fafabot/HomeWise/HomeWise_CAD_preliminar/homewise_cad/08_suporte_3d_case_pzem004t.stl

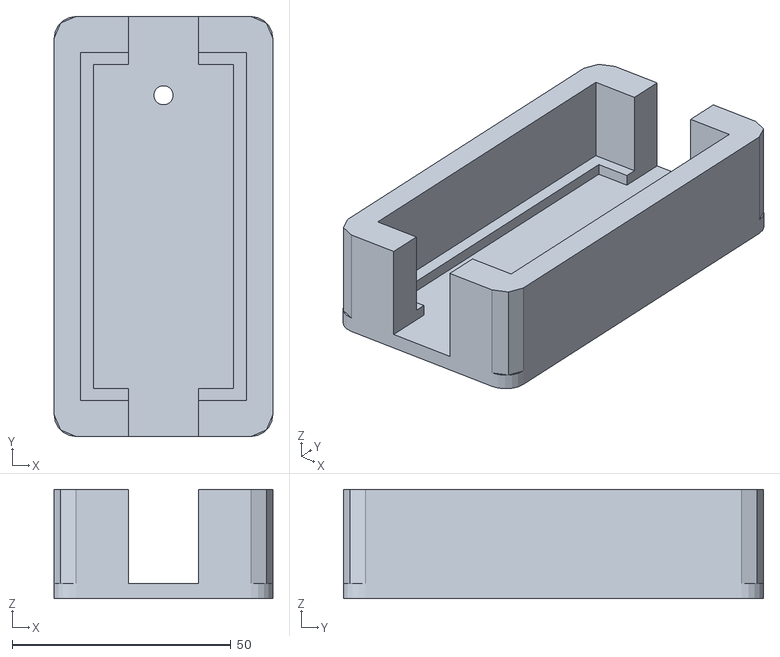
[picture p3: CAD file, 2026-11-12]
HomeWise_CAD_preliminar/homewise_cad/08_suporte_3d_case_pzem004t.stl
50.0 x 96.0 x 25.0
