fafabot/HomeWise/HomeWise_CAD_preliminar/homewise_cad/HomeWise_estrutura.stl

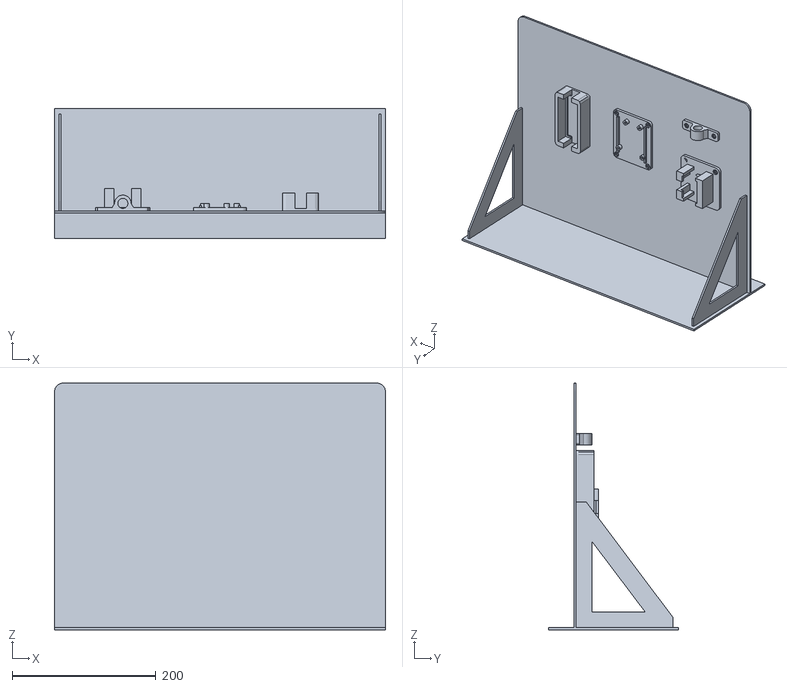
[picture p4: CAD file, 2026-11-12]
HomeWise_CAD_preliminar/homewise_cad/HomeWise_estrutura.stl
460.0 x 180.0 x 343.0
