fafabot/HomeWise/HomeWise_CAD_preliminar/homewise_cad/06_suporte_3d_berco_yfs201.stl

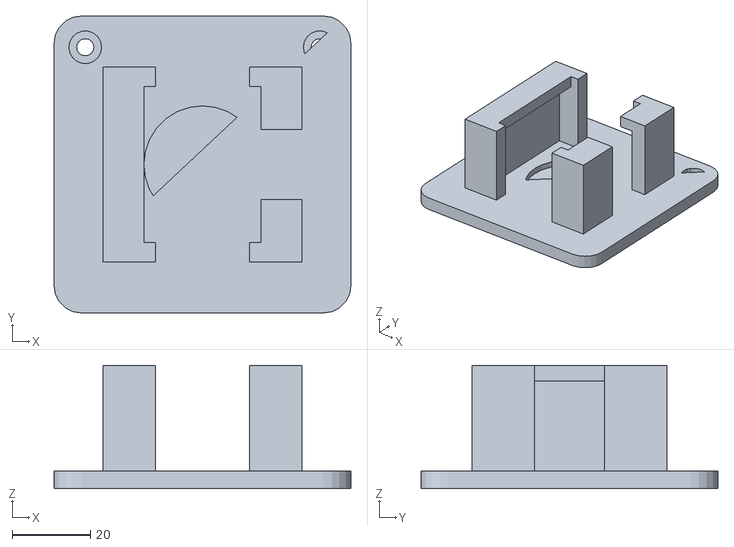
[picture p5: CAD file, 2026-11-12]
HomeWise_CAD_preliminar/homewise_cad/06_suporte_3d_berco_yfs201.stl
76.0 x 76.0 x 31.5
