fafabot/HomeWise/HomeWise_CAD_preliminar/homewise_cad/02_base_totem_460x180.dxf

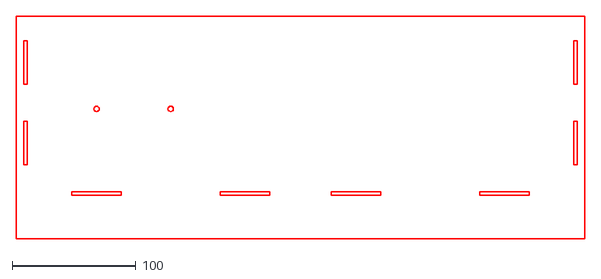
[picture p6: CAD file, 2026-11-12]
HomeWise_CAD_preliminar/homewise_cad/02_base_totem_460x180.dxf
460.0 x 180.0
