fafabot/HomeWise/HomeWise_CAD_preliminar/homewise_cad/05_suporte_3d_clipe_funil.stl

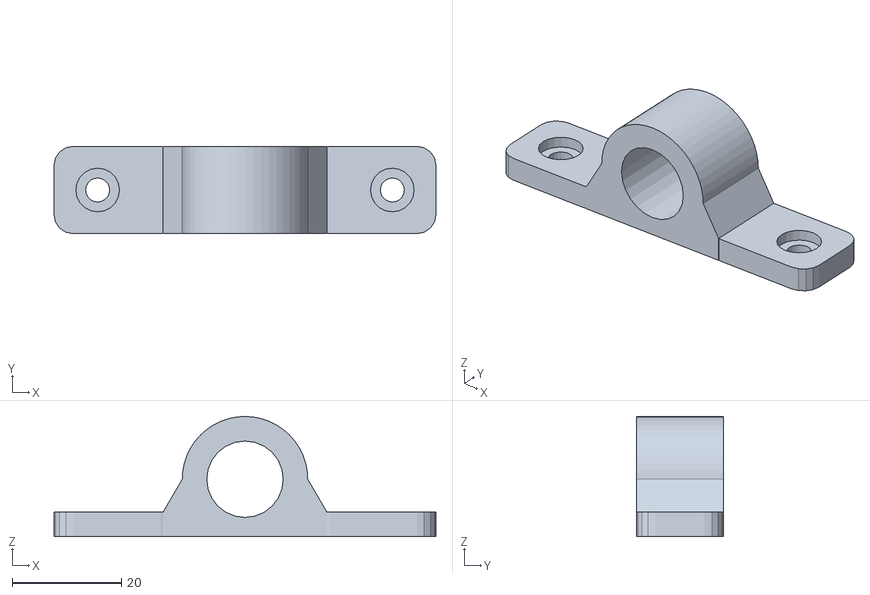
[picture p7: CAD file, 2026-11-12]
HomeWise_CAD_preliminar/homewise_cad/05_suporte_3d_clipe_funil.stl
70.0 x 16.0 x 22.0
