fafabot/HomeWise/HomeWise_CAD_preliminar/homewise_cad/07_suporte_3d_base_wemos_d1.stl

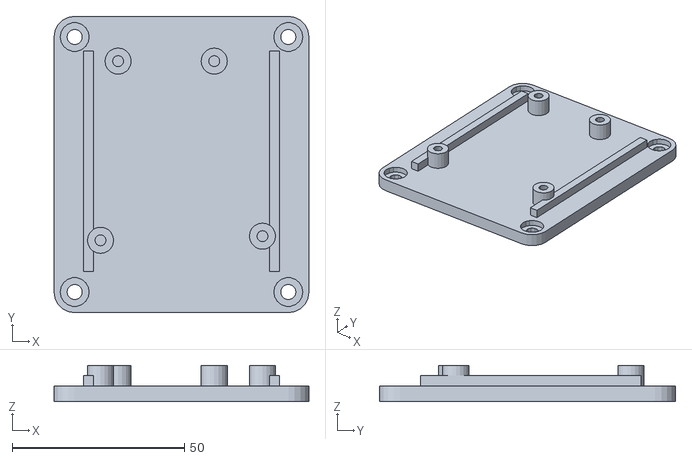
[picture p8: CAD file, 2026-11-12]
HomeWise_CAD_preliminar/homewise_cad/07_suporte_3d_base_wemos_d1.stl
74.0 x 86.0 x 10.5
