fafabot/HomeWise/HomeWise_CAD_preliminar/homewise_cad/03_escora_vazada_esquerda.dxf

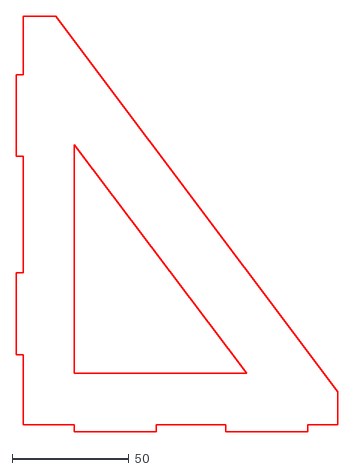
[picture p9: CAD file, 2026-11-12]
HomeWise_CAD_preliminar/homewise_cad/03_escora_vazada_esquerda.dxf
138.0 x 178.0
