fafabot/HomeWise/HomeWise_CAD_preliminar/homewise_cad/01_painel_totem_460x340.dxf

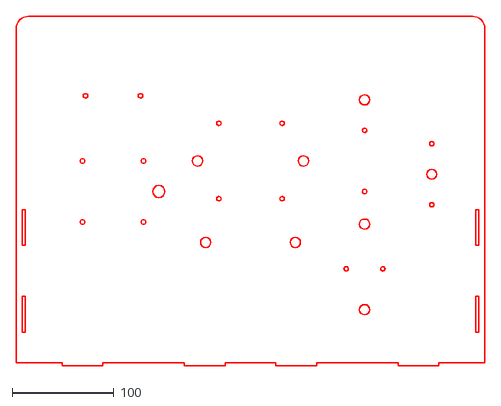
[picture p10: CAD file, 2026-11-12]
HomeWise_CAD_preliminar/homewise_cad/01_painel_totem_460x340.dxf
460.0 x 343.0
