fafabot/HomeWise/include/energia.h

#ifndef ENERGIA_H
#define ENERGIA_H

void iniciarEnergia();
void atualizarEnergia();

float obterTensao();
float obterCorrente();
float obterPotencia();
float obterEnergia();
bool cargaLigada();
bool pzemComunicando();

void resetarConsumoDiarioEnergia();

#endif
