fafabot/HomeWise/include/historico.h

#ifndef HISTORICO_H
#define HISTORICO_H

void iniciarHistorico();
int verificarDia();

float obterAguaDoDia(int dia);
float obterEnergiaDoDia(int dia);
int obterDiasFinalizados();
int obterDiasNoMes();

#endif
