fafabot/HomeWise/include/credenciais.example.h

#ifndef CREDENCIAIS_EXAMPLE_H
#define CREDENCIAIS_EXAMPLE_H

// Modelo de credenciais locais (copie para credenciais.h e preencha com seus dados)
// O arquivo credenciais.h esta no .gitignore e nunca deve ser enviado para o GitHub.

constexpr char WIFI_SSID[] = "SUA_REDE_WIFI";
constexpr char WIFI_PASSWORD[] = "SUA_SENHA_WIFI";

// Chave da Web API do Google Firebase (obtida no Console do Firebase > Configuracoes do Projeto)
constexpr char FIREBASE_API_KEY[] = "SUA_API_KEY_DO_FIREBASE";

#endif
