fafabot/HomeWise/(commit log)

2026-08-14 Protótipo de commit inicial do projeto HomeWise, incluindo arquivos de configuração, cabeçalhos e implementações básicas para os módulos de água e energia.
2026-08-14 Refatora módulo de energia para controlar carga simulada
2026-08-14 Organiza lógica de energia e prepara integração futura com PZEM
2026-08-14 Corrige integração dos módulos de água e energia no ESP32
    [main.cpp]
2026-08-14 Corrige conexão do ESP32 ao Serial Monitor do Wokwi
2026-08-21 comeco do trabalho de analise de dados, com a criacao de uma nova classe para isso, e a criacao de uma classe para o historico de dados.
2026-08-21 fix: centraliza pulsos simulados de agua
    [config.h]
2026-08-21 fix: usa contador unico de pulsos da agua
    [agua.cpp]
2026-08-21 fix: remove contador duplicado de agua no main
    [main.cpp]
2026-08-21 resetar o consumo diário de água ao final de cada dia, garantindo que os dados de consumo sejam reiniciados corretamente para o próximo dia.
    [agua.cpp, historico.cpp]
2026-08-21 Adiciona consulta de consumo de agua por dia
2026-08-21 Implementa consulta de agua por dia no historico
2026-08-31 implemento do historico de energia, com reset do consumo diário e armazenamento do consumo diário em um array.
    [energia.cpp, energia.h, historico.cpp, historico.h]
2026-08-31 Prepara historico para meses de ate 31 dias
2026-09-01 fix: protege interface do historico
    [historico.h]
2026-09-01 fix: completa interface de analise
    [analise.h]
2026-09-01 fix: protege leitura e reset dos pulsos de agua
    [agua.cpp]
2026-09-01 fix: valida e organiza historico diario
    [historico.cpp]
2026-09-01 fix: compara consumo com dias anteriores
    [analise.cpp]
2026-09-01 fix: contabiliza energia antes da troca de carga
    [energia.cpp]
2026-09-10 Adiciona interface do modulo de tempo
2026-09-10 Implementa controle de tempo simulado
2026-09-10 Separa controle de tempo do historico
2026-09-10 Integra modulo de tempo ao fluxo principal
2026-09-11 Migrar HomeWise para WEMOS D1 R1 (ESP8266)
    Atualiza PlatformIO, pinos, sensor de vazao e PZEM-004T para ESP8266 e arquiva a simulacao ESP32/Wokwi.
2026-09-11 Corrigir placa para LOLIN NodeMCU V3 ESP8266
2026-09-11 Atualizar configuracao para LOLIN NodeMCU V3
2026-09-11 Atualizar identificacao do prototipo para NodeMCU V3
2026-09-18 Adicionar dashboard web inicial do HomeWise
    Cria uma interface responsiva em HTML, CSS e JavaScript para visualizar consumo de agua e energia, historico, metas, alertas e dispositivos. Mantem dados simulados identificados ate a integracao da API REST e documenta a nova pasta web.
2026-10-01 feat: prepare physical water sensor configuration
2026-10-01 feat: calculate real-time water flow
2026-10-01 feat: display physical water flow
2026-10-01 docs: update physical prototype status
2026-10-01 feat: adiciona modulo de comunicacao Wi-Fi
2026-10-01 docs: adiciona modelo de credenciais Wi-Fi
2026-10-09 Corrige firmware e prepara API MySQL
    Consolida correcoes do firmware ESP8266, configuracao Wi-Fi, API com persistencia MySQL, esquema SQL, documentacao e verificacoes automatizadas.
    [agua.cpp, comunicacao.cpp, config.h, energia.cpp, main.cpp]
2026-10-12 mudanca da logica de envio de dados para o servidor, agora envia os dados em formato JSON, e adicionada a funcionalidade de envio do QRCode para o servidor.
2026-10-16 docs: adiciona dossie de contexto e continuidade para desenvolvimento no SENAI
2026-10-16 docs: atualiza politica de isolamento de centrais no dossie
2026-10-16 chore(firmware): adiciona fallback automatico para credenciais.example.h se credenciais.h nao existir
2026-10-16 teste feito no senai e troca para o wemos d1r1
2026-11-12 Organização da parte física do projeto HomeWise, incluindo arquivos CAD, STL e SCAD para fabricação e montagem do dispositivo.
